sv1onw/Si5351_OLED_DFS/calibration_si5351.png

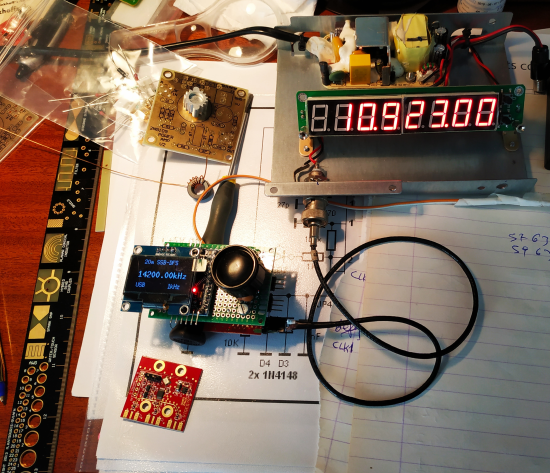
calibration_si5351.png
