sv1onw/Si5351_OLED_DFS/si5351_yello_blue_oled.jpg

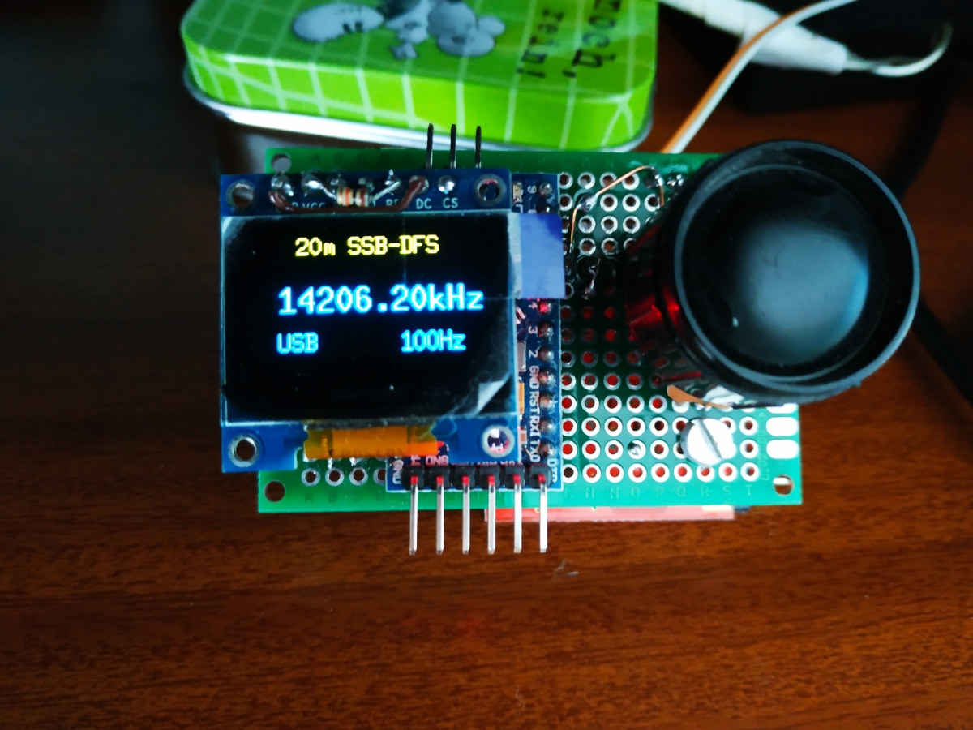
si5351_yello_blue_oled.jpg
