sv1onw/Si5351_OLED_DFS/iler20_calcs.png

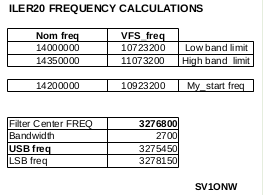
iler20_calcs.png
