sv1onw/Si5351_OLED_DFS/iler20_sm1.png

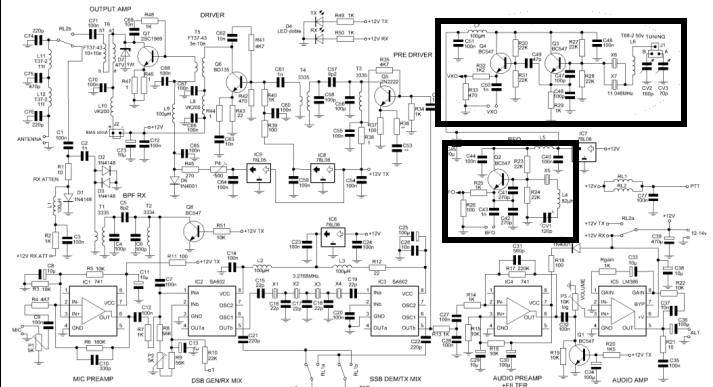
iler20_sm1.png
