sv1onw/Si5351_OLED_DFS/just_oled_ctrl_bb.png

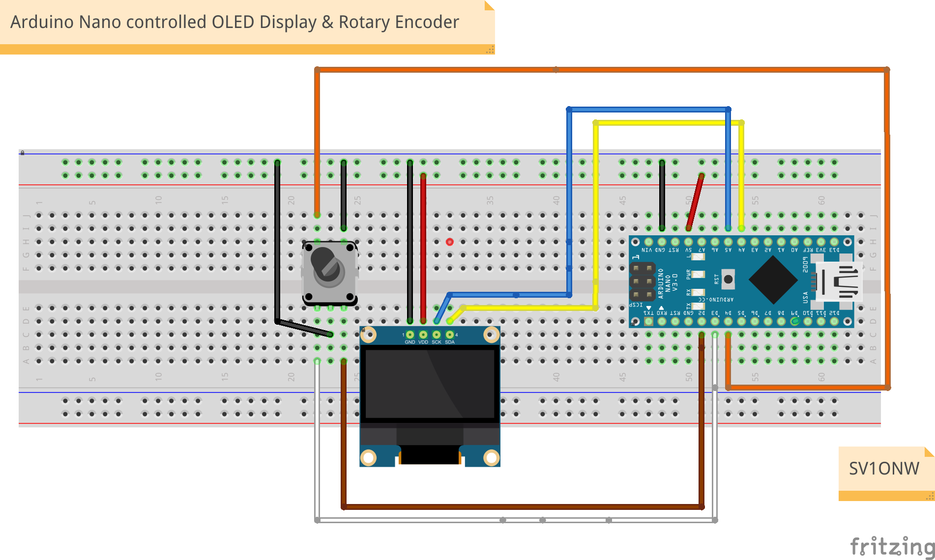
just_oled_ctrl_bb.png
