sv1onw/Si5351_OLED_DFS/si5351_atmega328_dfs2_bb.png

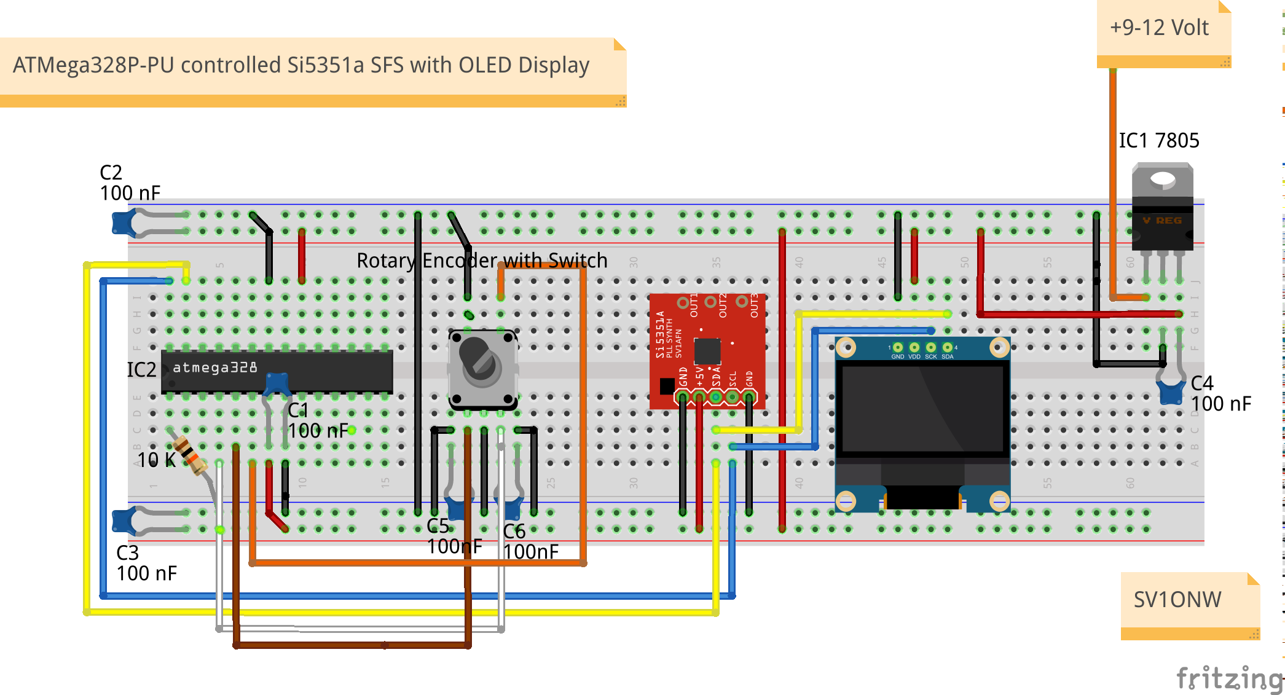
si5351_atmega328_dfs2_bb.png
