sv1onw/Si5351_OLED_DFS/si5351_back_bd.jpg

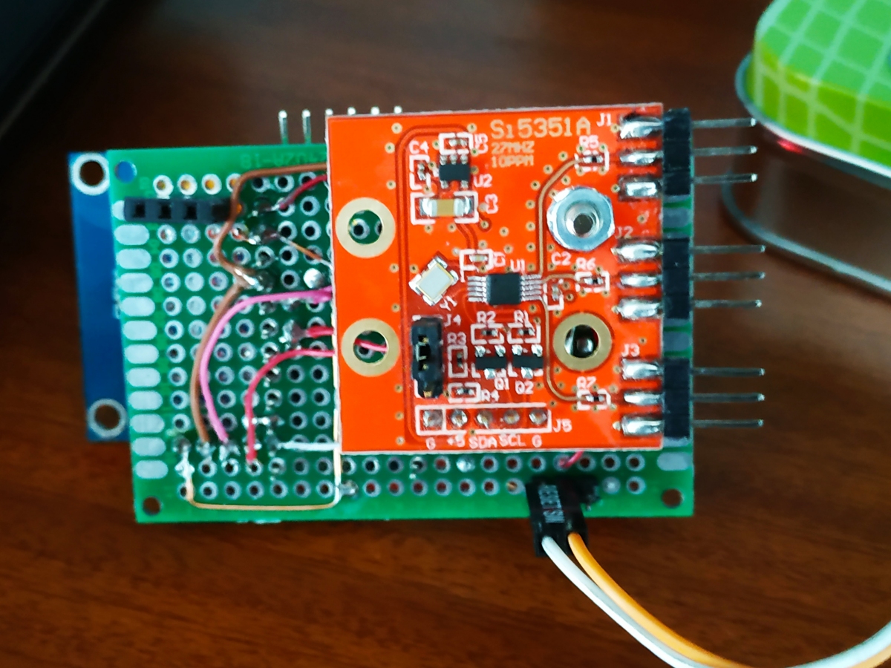
si5351_back_bd.jpg
