sv1onw/Si5351_OLED_DFS/si5351_bare_bd.jpg

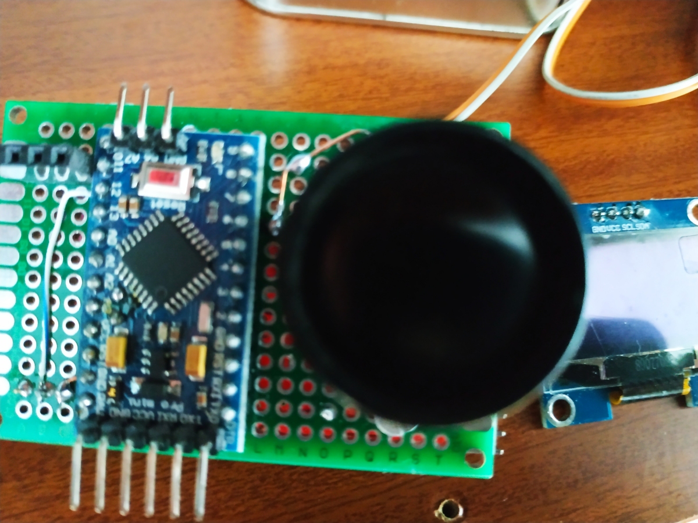
si5351_bare_bd.jpg
