sv1onw/Si5351_OLED_DFS/si5351_nano_dfs_1_bb.png

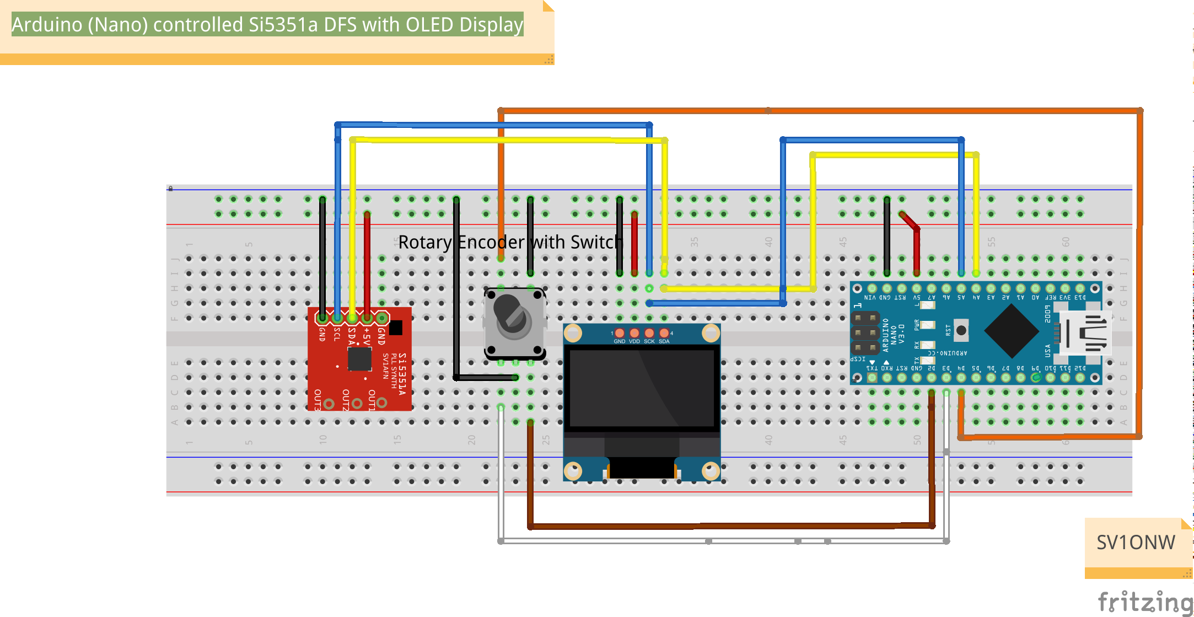
si5351_nano_dfs_1_bb.png
