sv1onw/Si5351_OLED_DFS/si5351_white_oled.jpg

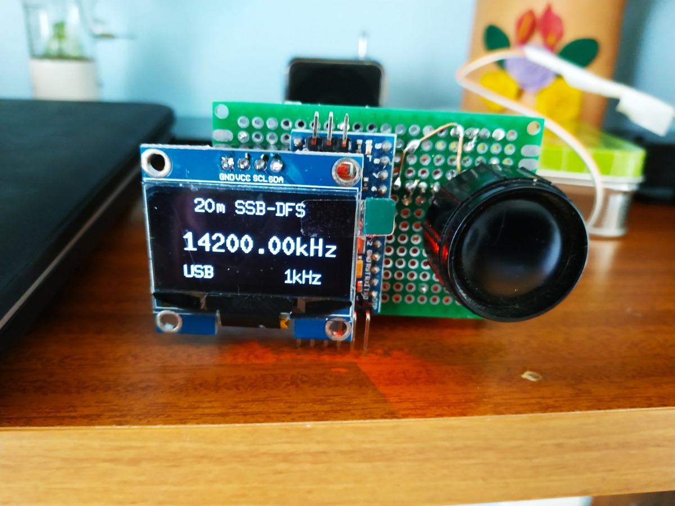
si5351_white_oled.jpg
