sv1onw/Si5351_OLED_DFS/si5351a_by_sv1afn.png

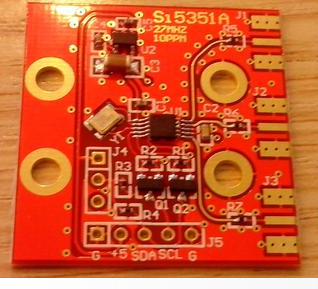
si5351a_by_sv1afn.png
